mooltipass/minible_hw/README.md

# minible_hw
Repository for the Mini BLE Hardware

## [](#header-2)Licenses
<p align="center">
  Mooltipass Mini BLE
</p>
