mooltipass/minible_hw/(threads)

Thread 1 (2020-08-18):

Few questions about sourcing some parts

jeandet, 2020-08-18:
Hello, first thanks for this awesome HW!
I wanted one for a log time but previous models aren't available and delay for mini ble was quite long, so I decided to make my own one!
I've everything except:
- Smart card socket, from design I can't find a matching ref online.
- SRBE210200's plastic wheel, when I ordered it I didn't anticipate that it would be without the wheel. Then I tried to find something online but no luck and ALPS docs aren't much helpful.
- OLED screen, references aren't so difficult to find, the issue is more to source it inside Europe.
That would be awesome if you could share the references you use.

limpkin, 2020-08-26:
- smartcard socket: https://www.alibaba.com/trade/search?fsb=y&IndexArea=product_en&CatId=&SearchText=KF011C&viewtype=&tab=
- plastic wheel: these are custom made by us.. send me an email at support[at]themooltipass[dot]com and i'll have some shipped to you
- oled screen: we're sourcing from china actually...

Closed 2020-08-26.

Thread 2 (2020-10-23):

Replace the wheel by 3 buttons

Trim, 2020-10-23:
Hello,

I don't know how far this new product is from shipping, but I wanted to do a hardware suggestion.

I'm owner of a Mooltipass Mini and it felt down by accident on the ground this night. It seems that the wheel took all the shock.

Now the Mooltipass Mini is broken because the wheel is pressed down and I've discovered, I won't be able to repair it [without breaking the case](https://fry.blueblue.fr/mpm/teardown/).

So, after this experience, I think the wheel is very fragile [1] and it should be replaced by three buttons to navigate on the menus (with the middle button as validating button).

The advantage of the button is they are more robust and, with software, we can simulate fast scroll when the button is kept pressed.

In conclusion, if this new Mini BLE can have bluetooth and the 3 buttons, I think the hardware will be way more robust, because the USB port will be less pluged in/out and the buttons will be well protected by the case.

[1]: even with normal usage, my wheel didn't work very well any more because some of the steps seemed to be to used and didn't give signal to the hardware.

Thread 3 (2021-06-25):

Hardware: Scroll wheel too slippery, design change recommendation

kbembedded, 2021-06-25:
The scroll wheel on the miniBLE does not have a stiff enough knurling on it to allow good finger contact. Its very rounded, and in cold, dry climates, a finger tends to slide across it rather than spin it. This requires more pressure to get the wheel to turn, which results in spurious wheel clicks.

If there are going to be further builds through the future and lifetime of the miniBLE, I highly recommend finding a different scroll wheel design or working with the manufacturer.

As a workaround, I'm going to try to do some light filing on the one I have here. If I find it to be successful I can report back with photos and more information for others.

Thread 4 (2021-07-29):

Feature Request- Add battery disconnect switch.

SeanSingh, 2021-07-29:
Missing feature

Add a small, physical, difficult to reach switch, inline with the battery, to act as a battery disconnect. Does not need to be externally accessible.
Justification

I noticed that the battery would need to be de-soldered, to replace or repair any other part.

The connector to the display is very flimsy, to replace the display, the battery has to be de-soldered, because there is no switch.
Workarounds

Are there any workarounds you currently have in place because the feature is missing?

8<------------------------ END FEATURE REQUEST --------------------------------

Thread 5 (2025-06-26):

Bluetooth ATBTLC1000A-MU-T obsolete

lcp5y3, 2025-06-26:
The Bluetooth chip [ATBTLC1000A-MU-T](https://www.digikey.com/en/products/detail/microchip-technology/ATBTLC1000A-MU-T/6831868) is no longer available.

Digikey suggest the [SX1231HIMLTRT](https://www.digikey.com/en/products/detail/semtech-corporation/SX1231HIMLTRT/4259558) as replacement part, but it's not pin-to-pin compatible.

Microchip had a chip with same package [ISO1871](https://www.digikey.com/en/products/detail/microchip-technology/IS1871SF-102/13557888) but it's not pin-to-pin compatible.

So, have you already choose a replacement part for this chip ?
