mooltipass/minible_hw/dev_board/mini_ble.kicad_pcb

## KiCad design dev_board/mini_ble.kicad_pcb (2020-07-23)

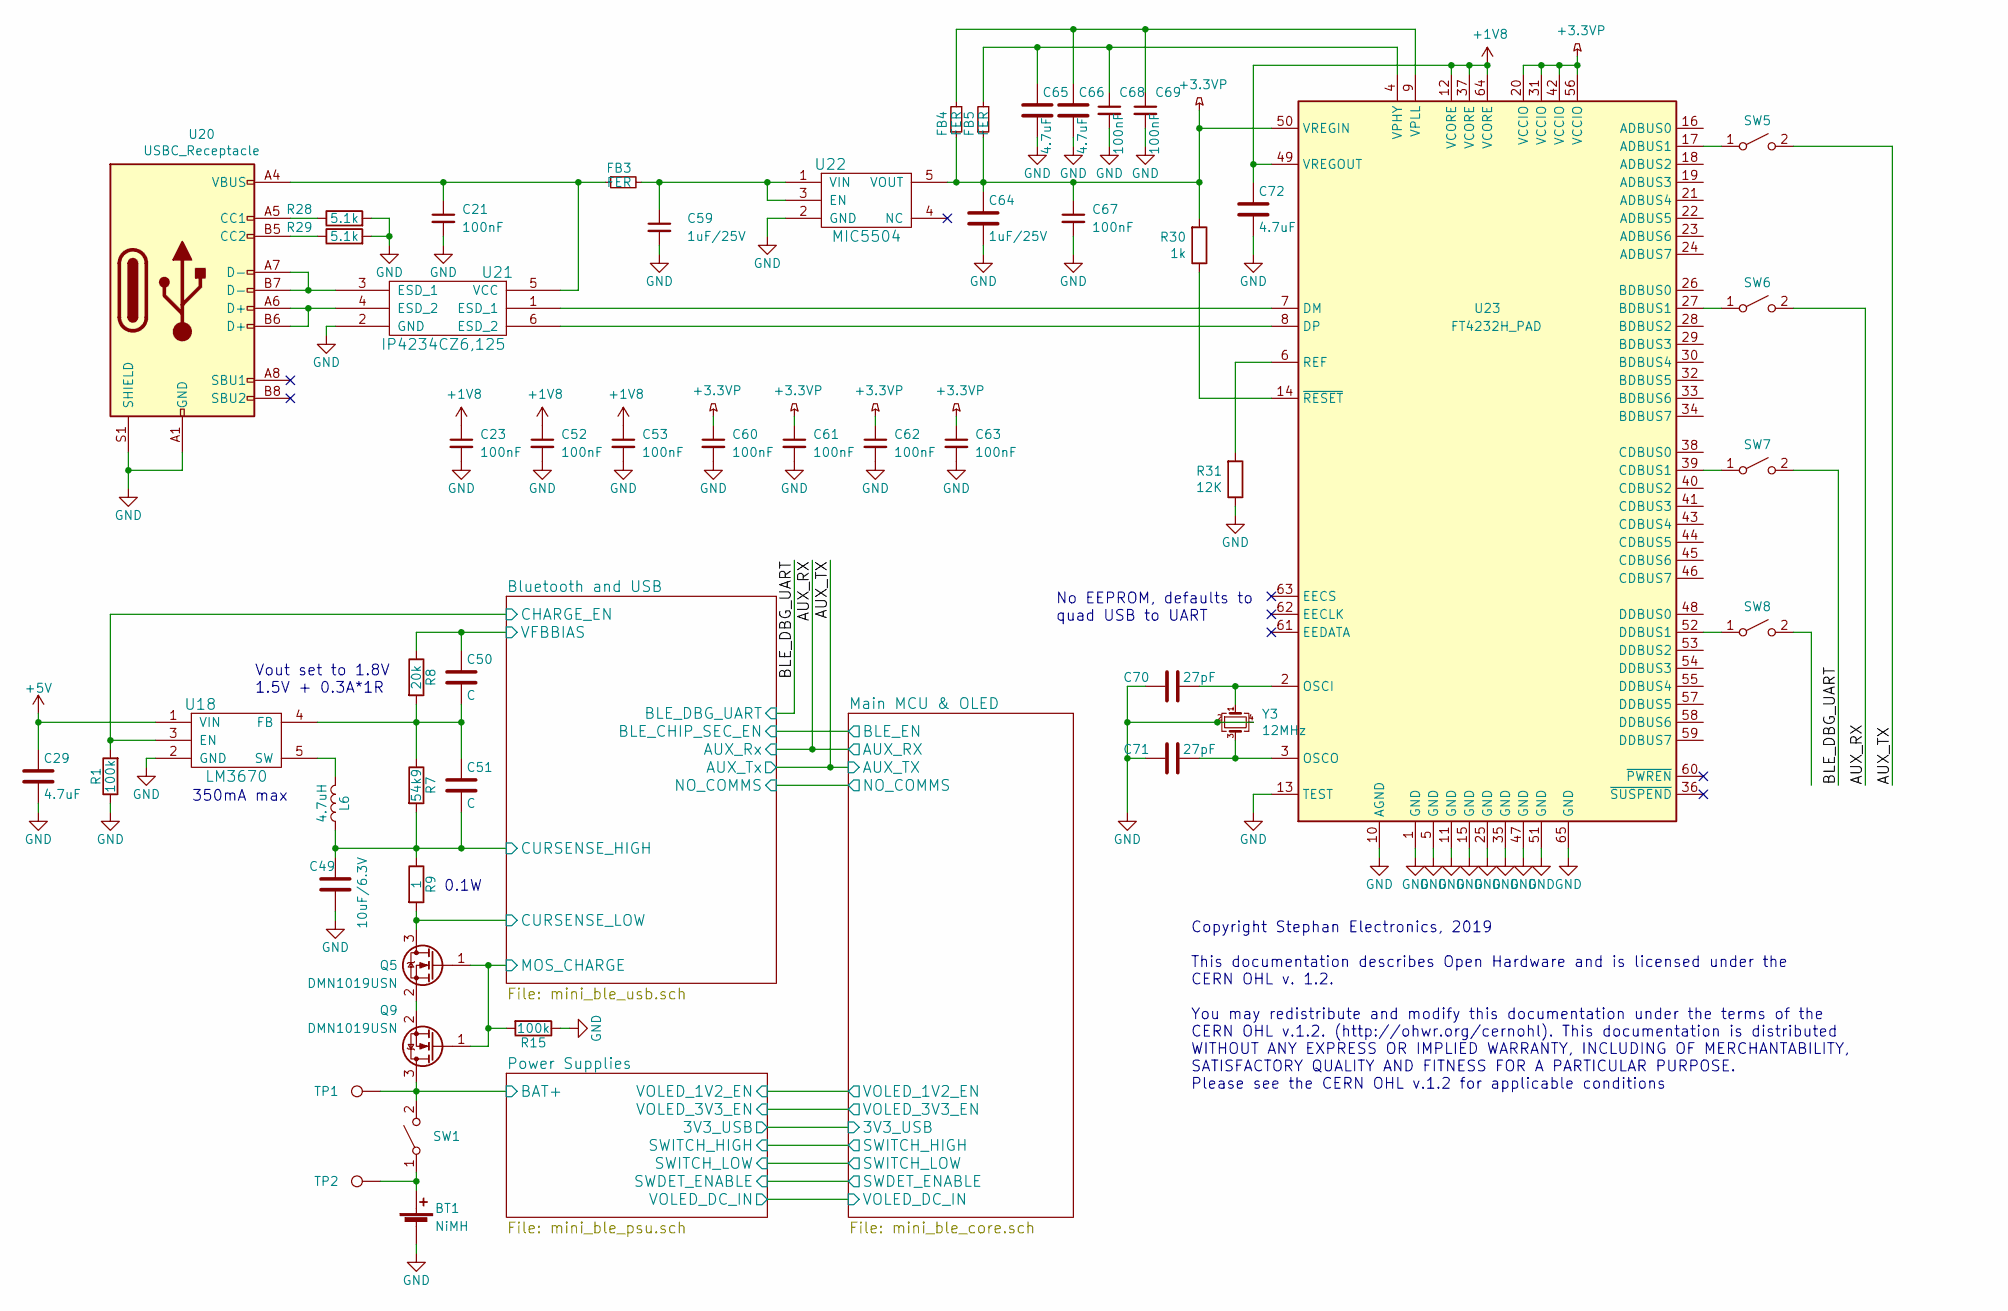
[picture p5: schematic mini_ble.sch]

Parts:
BT1: NiMH; BAT_TWOTHIRD_AAA
C21, C23, C52, C53, C60, C61, C62, C63, C67, C68, C69: 100nF; C_0603_1608Metric
C29, C65, C66, C72: 4.7uF; C_0603_1608Metric
C49: 10uF/6.3V; C_0603_1608Metric
C50, C51: C; C_0402_1005Metric
C59, C64: 1uF/25V; C_0603_1608Metric
C70, C71: 27pF; C_0402_1005Metric
FB3, FB4, FB5: FER; R_0603_1608Metric
L6: 4.7uH; L_0805_2012Metric
Q5, Q9: DMN1019USN; SC-59
R1, R15: 100k; R_0402_1005Metric
R7: 54k9; R_0402_1005Metric
R8: 20k; R_0402_1005Metric
R9: 1; R_0603_1608Metric
R28, R29: 5.1k; R_0402_1005Metric
R30: 1k; R_0402_1005Metric
R31: 12K; R_0402_1005Metric
SW1, SW5, SW6, SW7, SW8: SW_SPST; DIP_1POS_KAE01LAGT
TP1, TP2: TestPoint; TP_KEYSTONE_500X
U18: LM3670; SOT-23-5
U20: USBC_Receptacle; USB_C_Receptacle_GT-USB-7010
U21: IP4234CZ6,125; TSOP-6_1.65x3.05mm_P0.95mm
U22: MIC5504; SOT-23-5
U23: FT4232H_PAD; QFN-64-1EP_9x9mm_P0.5mm_EP4.35x4.35mm
Y3: 12MHz; Crystal_SMD_2520-4Pin_2.5x2.0mm

Connections:
+1V5: Q9.3 (D), SW1.2 (B), TP1.1; also elsewhere on the board
+1V8: C23.1, C52.1, C53.1, C72.1, U23.12 (VCORE), U23.37 (VCORE), U23.49 (VREGOUT), U23.64 (VCORE)
+3.3VP: C60.1, C61.1, C62.1, C63.1, C64.1, C67.1, FB4.1, FB5.1, R30.2, U22.5 (VOUT), U23.20 (VCCIO), U23.31 (VCCIO), U23.42 (VCCIO), U23.50 (VREGIN), U23.56 (VCCIO)
+5V: C29.1, U18.1 (VIN); also elsewhere on the board
/AUX_RX: SW6.2 (B); also elsewhere on the board
/AUX_TX: SW5.2 (B); also elsewhere on the board
/BLE_DBG_UART: SW7.2 (B); also elsewhere on the board
/Bluetooth and USB/CHARGE_EN: R1.2, U18.3 (EN); also elsewhere on the board
/Bluetooth and USB/CURSENSE_HIGH: C49.1, C51.2, L6.1, R7.2, R9.1; also elsewhere on the board
/Bluetooth and USB/CURSENSE_LOW: Q5.3 (D), R9.2; also elsewhere on the board
/Bluetooth and USB/MOS_CHARGE: Q5.1 (G), Q9.1 (G), R15.2; also elsewhere on the board
/Bluetooth and USB/VFBBIAS: C50.1, R8.1; also elsewhere on the board
GND: BT1.2 (-), C21.2, C23.2, C29.2, C49.2, C52.2, C53.2, C59.2, C60.2, C61.2, C62.2, C63.2, C64.2, C65.2, C66.2, C67.2, C68.2, C69.2, C70.1, C71.1, C72.2, R1.1, R15.1, R28.2, R29.2, R31.1, U18.2 (GND), U20.A1 (GND), U20.A12 (GND), U20.B1 (GND), U20.B12 (GND), U20.S1 (SHIELD), U21.2 (GND), U22.2 (GND), U23.1 (GND), U23.5 (GND), U23.10 (AGND), U23.11 (GND), U23.13 (TEST), U23.15 (GND), U23.25 (GND), U23.35 (GND), U23.47 (GND), U23.51 (GND), U23.65 (GND), Y3.2, Y3.4; also elsewhere on the board
unnamed: BT1.1 (+), SW1.1 (A), TP2.1
unnamed: C21.1, FB3.1, U20.A4 (VBUS), U20.A9 (VBUS), U20.B4 (VBUS), U20.B9 (VBUS), U21.5 (VCC)
unnamed: C50.2, C51.1, R7.1, R8.2, U18.4 (FB)
unnamed: C59.1, FB3.2, U22.1 (VIN), U22.3 (EN)
unnamed: C65.1, C68.1, FB5.2, U23.4 (VPHY)
unnamed: C66.1, C69.1, FB4.2, U23.9 (VPLL)
unnamed: C70.2, U23.2 (OSCI), Y3.1
unnamed: C71.2, U23.3 (OSCO), Y3.3
unnamed: L6.2, U18.5 (SW)
unnamed: Q5.2 (S), Q9.2 (S)
unnamed: R28.1, U20.A5 (CC1)
unnamed: R29.1, U20.B5 (CC2)
unnamed: R30.1, U23.14 (~RESET)
unnamed: R31.2, U23.6 (REF)
unnamed: SW5.1 (A), U23.17 (ADBUS1)
unnamed: SW6.1 (A), U23.27 (BDBUS1)
unnamed: SW7.1 (A), U23.39 (CDBUS1)
unnamed: SW8.1 (A), U23.52 (DDBUS1)
unnamed: U20.A6 (D+), U20.B6 (D+), U21.4 (ESD_2)
unnamed: U20.A7 (D-), U20.B7 (D-), U21.3 (ESD_1)
unnamed: U21.1 (ESD_1), U23.7 (DM)
unnamed: U21.6 (ESD_2), U23.8 (DP)

Notes on the sheet:
Copyright Stephan Electronics, 2019 This documentation describes Open Hardware and is licensed under the CERN OHL v. 1.2. You may redistribute and modify this documentation under the terms of the CERN OHL v.1.2. (http://ohwr.org/cernohl). This documentation is distributed WITHOUT ANY EXPRESS OR IMP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
350mA max
Vout set to 1.8V 1.5V + 0.3A*1R
0.1W
No EEPROM, defaults to quad USB to UART

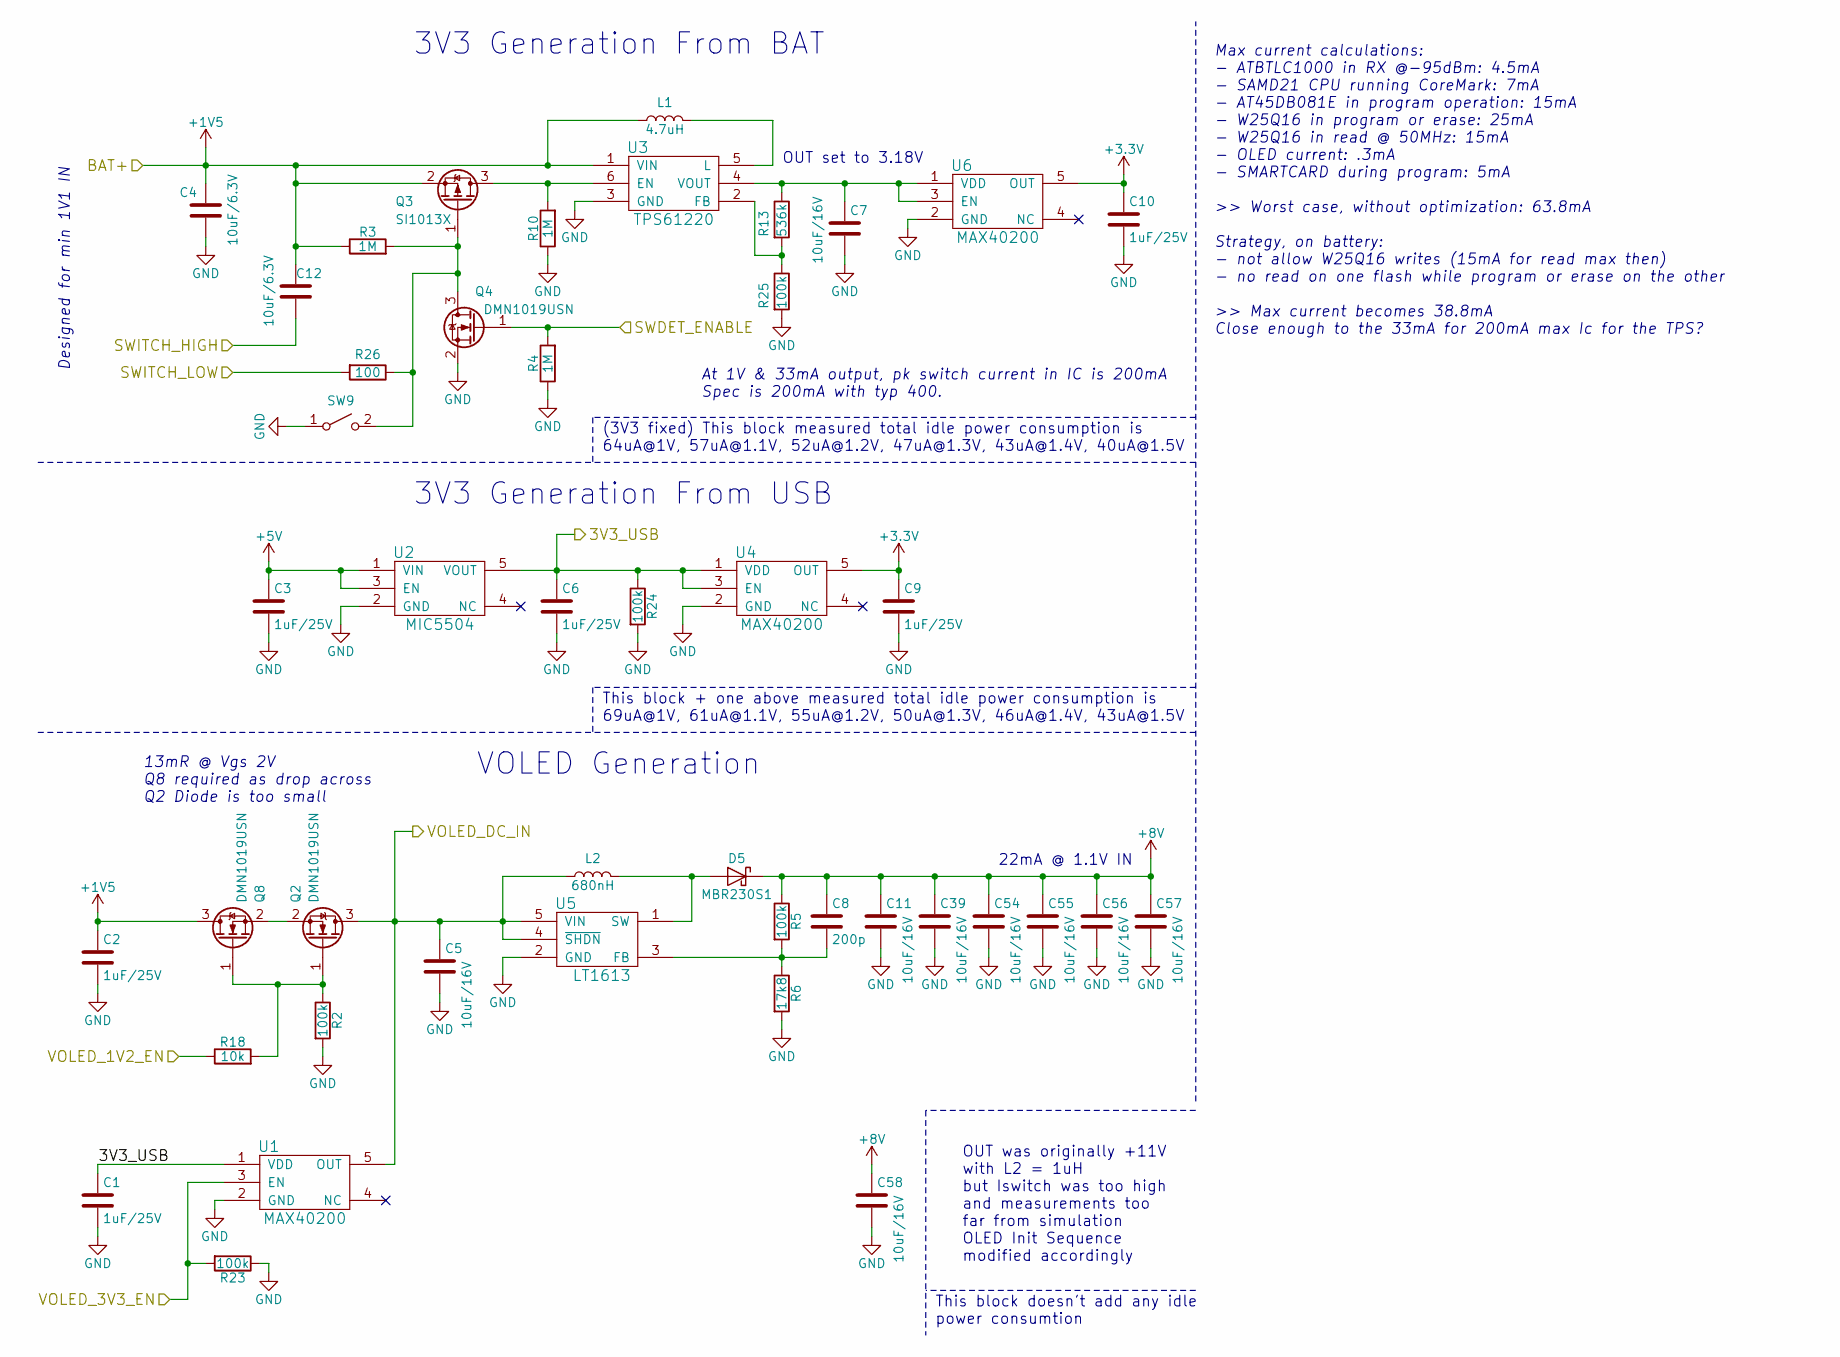
[picture p6: schematic mini_ble_psu.sch]

Parts:
C1, C2, C3, C6, C9, C10: 1uF/25V; C_0603_1608Metric
C4, C12: 10uF/6.3V; C_0603_1608Metric
C5, C7, C11, C39, C54, C55, C56, C57, C58: 10uF/16V; C_0805_2012Metric
C8: 200p; C_0402_1005Metric
D5: MBR230S1; D_SOD-123F
L1: 4.7uH; L_0805_2012Metric
L2: 680nH; L_0806
Q2, Q4, Q8: DMN1019USN; SC-59
Q3: SI1013X; SC89
R2, R5, R23, R24, R25: 100k; R_0402_1005Metric
R3, R4, R10: 1M; R_0402_1005Metric
R6: 17k8; R_0402_1005Metric
R13: 536k; R_0402_1005Metric
R18: 10k; R_0402_1005Metric
R26: 100; R_0402_1005Metric
SW9: SW_SPST; SWITCH_PUSH_6X3.5mm
U1, U4, U6: MAX40200; SOT-23-5
U2: MIC5504; SOT-23-5
U3: TPS61220; SOT-363_SC-70-6
U5: LT1613; TSOT-23-5

Connections:
+1V5: C2.1, C4.1, C12.1, L1.1, Q3.2 (S), Q8.3 (D), R3.1, U3.1 (VIN); also elsewhere on the board
+5V: C3.1, U2.1 (VIN), U2.3 (EN); also elsewhere on the board
+8V: C8.1, C11.1, C39.1, C54.1, C55.1, C56.1, C57.1, C58.1, D5.1 (K), R5.1; also elsewhere on the board
/Main MCU & OLED/3V3_USB: C1.1, C6.1, R24.1, U1.1 (VDD), U2.5 (VOUT), U4.1 (VDD), U4.3 (EN); also elsewhere on the board
/Main MCU & OLED/SWDET_ENABLE: Q4.1 (G), R4.2; also elsewhere on the board
/Main MCU & OLED/SWITCH_HIGH: C12.2; also elsewhere on the board
/Main MCU & OLED/SWITCH_LOW: R26.2; also elsewhere on the board
/Main MCU & OLED/VOLED_1V2_EN: R18.1; also elsewhere on the board
/Main MCU & OLED/VOLED_3V3_EN: R23.2, U1.3 (EN); also elsewhere on the board
/Main MCU & OLED/VOLED_DC_IN: C5.1, L2.1, Q2.3 (D), U1.5 (OUT), U5.4 (~SHDN), U5.5 (VIN); also elsewhere on the board
GND: C1.2, C2.2, C3.2, C4.2, C5.2, C6.2, C7.2, C9.2, C10.2, C11.2, C39.2, C54.2, C55.2, C56.2, C57.2, C58.2, Q4.2 (S), R2.2, R4.1, R6.2, R10.1, R23.1, R24.2, R25.2, SW9.1 (A), U1.2 (GND), U2.2 (GND), U3.3 (GND), U4.2 (GND), U5.2 (GND), U6.2 (GND); also elsewhere on the board
unnamed: C7.1, R13.1, U3.4 (VOUT), U6.1 (VDD), U6.3 (EN)
unnamed: C8.2, R5.2, R6.1, U5.3 (FB)
unnamed: D5.2 (A), L2.2, U5.1 (SW)
unnamed: L1.2, U3.5 (L)
unnamed: Q2.1 (G), Q8.1 (G), R2.1, R18.2
unnamed: Q2.2 (S), Q8.2 (S)
unnamed: Q3.1 (G), Q4.3 (D), R3.2, R26.1, SW9.2 (B)
unnamed: Q3.3 (D), R10.2, U3.6 (EN)
unnamed: R13.2, R25.1, U3.2 (FB)

Notes on the sheet:
3V3 Generation From USB
3V3 Generation From BAT
VOLED Generation
At 1V & 33mA output, pk switch current in IC is 200mA Spec is 200mA with typ 400.
Max current calculations: - ATBTLC1000 in RX @-95dBm: 4.5mA - SAMD21 CPU running CoreMark: 7mA - AT45DB081E in program operation: 15mA - W25Q16 in program or erase: 25mA - W25Q16 in read @ 50MHz: 15mA - OLED current: .3mA - SMARTCARD during program: 5mA >> Worst case, without optimization: 63.8mA S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
Designed for min 1V1 IN
13mR @ Vgs 2V Q8 required as drop across Q2 Diode is too small
(3V3 fixed) This block measured total idle power consumption is 64uA@1V, 57uA@1.1V, 52uA@1.2V, 47uA@1.3V, 43uA@1.4V, 40uA@1.5V
This block + one above measured total idle power consumption is 69uA@1V, 61uA@1.1V, 55uA@1.2V, 50uA@1.3V, 46uA@1.4V, 43uA@1.5V
This block doesn't add any idle power consumtion
22mA @ 1.1V IN
OUT was originally +11V with L2 = 1uH but Iswitch was too high and measurements too far from simulation OLED Init Sequence modified accordingly
OUT set to 3.18V

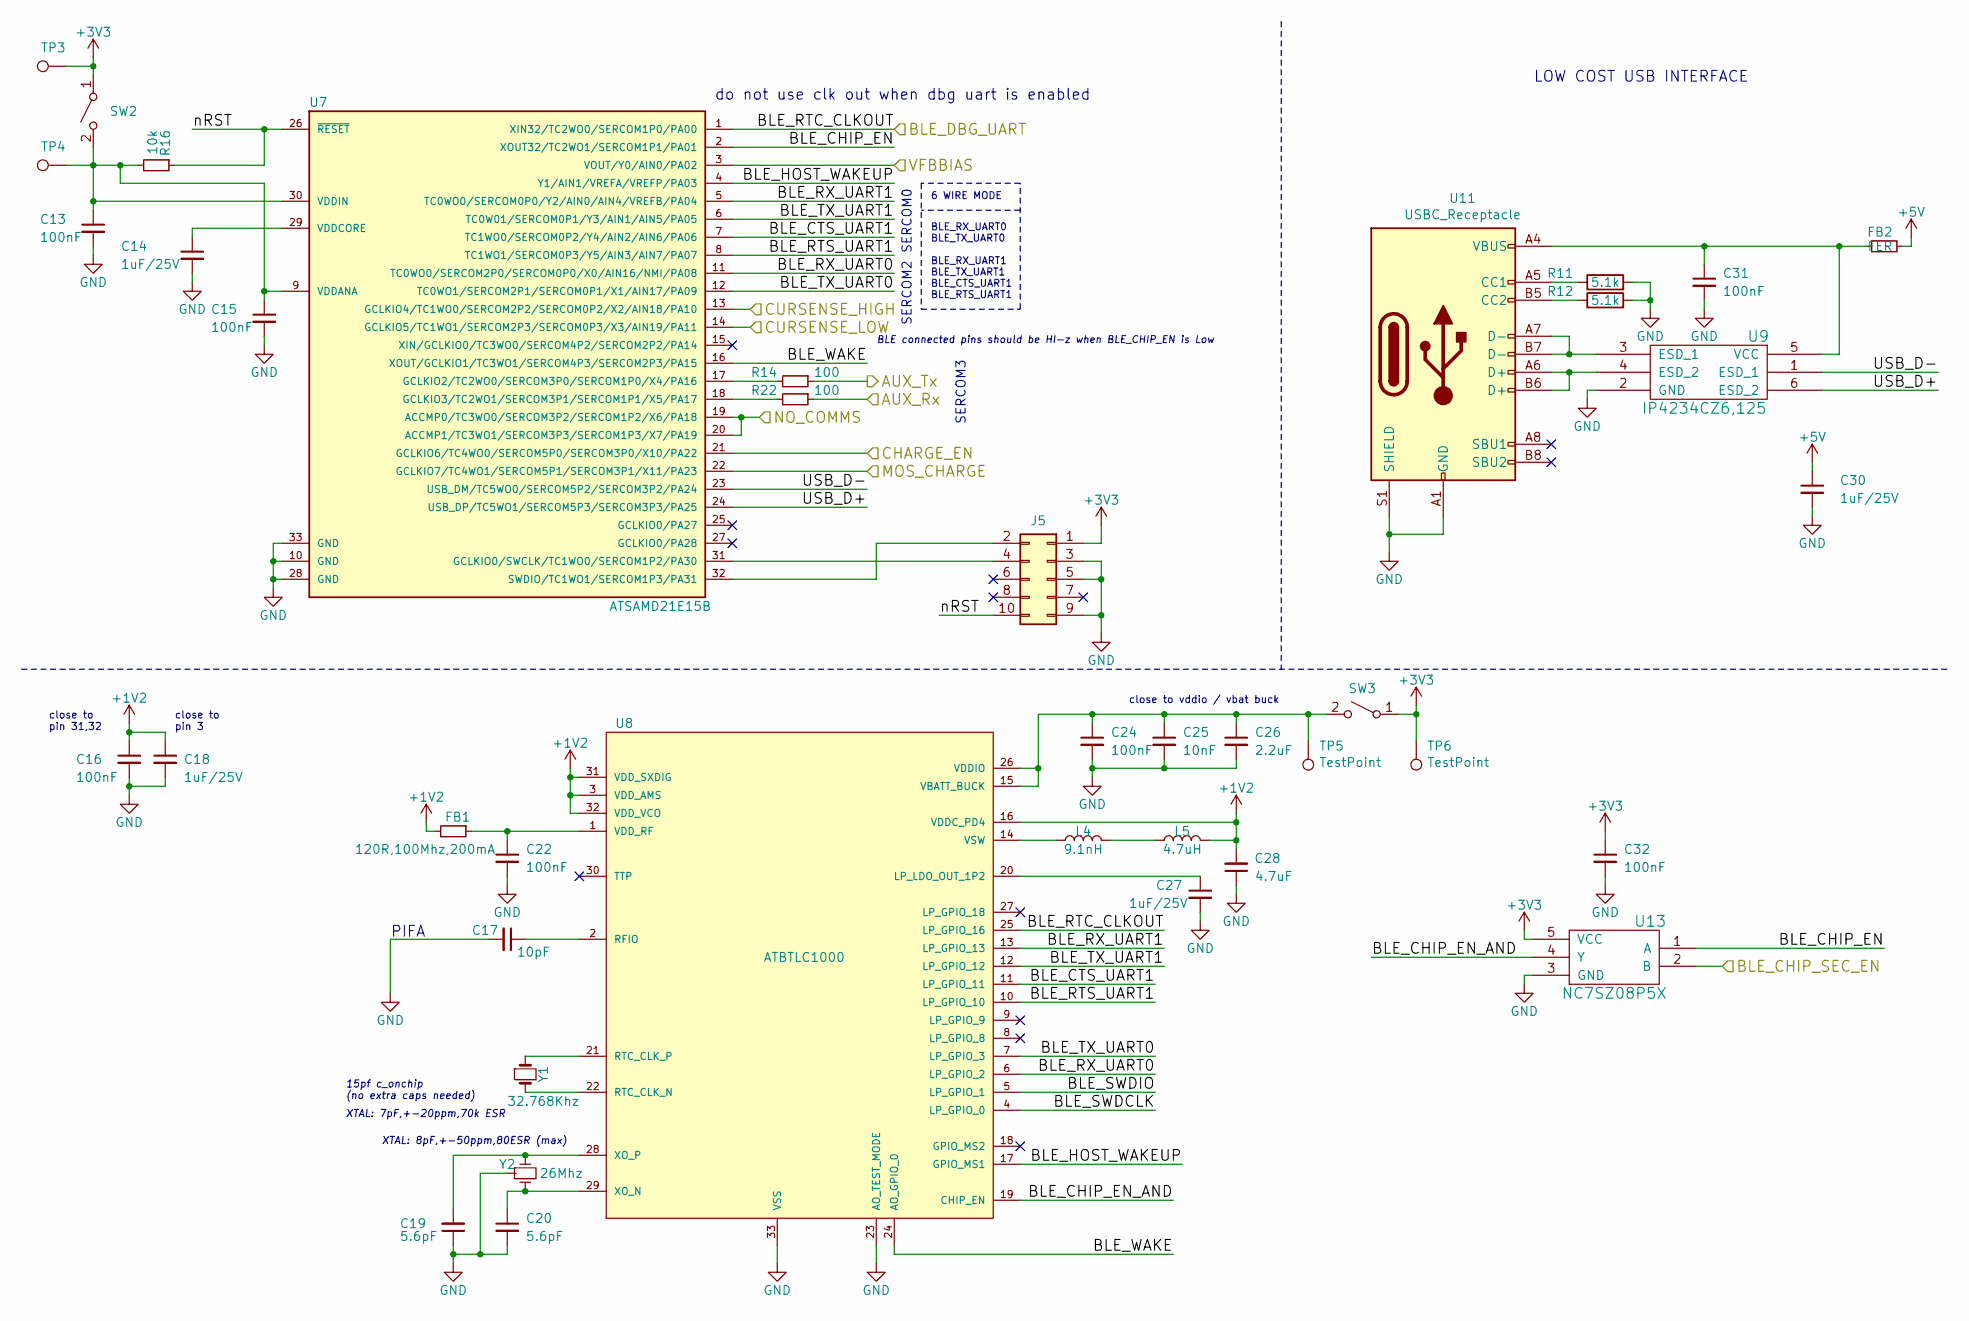
[picture p7: schematic mini_ble_usb.sch]

Parts:
C13, C15, C16, C22, C24, C31, C32: 100nF; C_0603_1608Metric
C14, C18, C27, C30: 1uF/25V; C_0603_1608Metric
C17: 10pF; C_0402_1005Metric
C19, C20: 5.6pF; C_0402_1005Metric
C25: 10nF; C_0603_1608Metric
C26: 2.2uF; C_0603_1608Metric
C28: 4.7uF; C_0603_1608Metric
FB1: 120R,100Mhz,200mA; R_0603_1608Metric
FB2: FER; R_0603_1608Metric
J5: Conn_02x05_Odd_Even; SHF-105-01-X-D-TH
L4: 9.1nH; L_0603_1608Metric
L5: 4.7uH; L_0805_2012Metric
R11, R12: 5.1k; R_0402_1005Metric
R14, R22: 100; R_0402_1005Metric
R16: 10k; R_0402_1005Metric
SW2, SW3: SW_SPST; DIP_1POS_KAE01LAGT
TP3, TP4, TP5, TP6: TestPoint; TP_KEYSTONE_500X
U7: ATSAMD21E15B; QFN-32-1EP_5x5mm_P0.5mm_EP3.7x3.7mm
U8: ATBTLC1000; QFN-32-1EP_4x4mm_Pitch0.4mm
U9: IP4234CZ6,125; TSOP-6_1.65x3.05mm_P0.95mm
U11: USBC_Receptacle; USB_C_Receptacle_GT-USB-7010
U13: NC7SZ08P5X; SOT-353_SC-70-5
Y1: 32.768Khz; Crystal_SMD_3215-2Pin_3.2x1.5mm
Y2: 26Mhz; Crystal_SMD_2016-4Pin_2.0x1.6mm

Connections:
+1V2: C16.1, C18.1, C28.2, FB1.2, L5.2, U8.3 (VDD_AMS), U8.16 (VDDC_PD4), U8.31 (VDD_SXDIG), U8.32 (VDD_VCO)
+5V: C30.1, FB2.2; also elsewhere on the board
/AUX_RX: R22.1; also elsewhere on the board
/AUX_TX: R14.1; also elsewhere on the board
/BLE_DBG_UART: U7.1 (XIN32/TC2WO0/SERCOM1P0/PA00), U8.25 (LP_GPIO_16); also elsewhere on the board
/Bluetooth and USB/BLE_CHIP_EN: U7.2 (XOUT32/TC2WO1/SERCOM1P1/PA01), U13.1 (A)
/Bluetooth and USB/BLE_CHIP_EN_AND: U8.19 (CHIP_EN), U13.4 (Y)
/Bluetooth and USB/BLE_CHIP_SEC_EN: U13.2 (B); also elsewhere on the board
/Bluetooth and USB/BLE_CTS_UART1: U7.7 (TC1WO0/SERCOM0P2/Y4/AIN2/AIN6/PA06), U8.11 (LP_GPIO_11)
/Bluetooth and USB/BLE_HOST_WAKEUP: U7.4 (Y1/AIN1/VREFA/VREFP/PA03), U8.17 (GPIO_MS1)
/Bluetooth and USB/BLE_RTS_UART1: U7.8 (TC1WO1/SERCOM0P3/Y5/AIN3/AIN7/PA07), U8.10 (LP_GPIO_10)
/Bluetooth and USB/BLE_RX_UART0: U7.11 (TC0WO0/SERCOM2P0/SERCOM0P0/X0/AIN16/NMI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), U8.6 (LP_GPIO_2)
/Bluetooth and USB/BLE_RX_UART1: U7.5 (TC0WO0/SERCOM0P0/Y2/AIN0/AIN4/VREFB/PA04), U8.13 (LP_GPIO_13)
/Bluetooth and USB/BLE_SWDCLK: U8.4 (LP_GPIO_0)
/Bluetooth and USB/BLE_SWDIO: U8.5 (LP_GPIO_1)
/Bluetooth and USB/BLE_TX_UART0: U7.12 (TC0WO1/SERCOM2P1/SERCOM0P1/X1/AIN17/PA09), U8.7 (LP_GPIO_3)
/Bluetooth and USB/BLE_TX_UART1: U7.6 (TC0W01/SERCOM0P1/Y3/AIN1/AIN5/PA05), U8.12 (LP_GPIO_12)
/Bluetooth and USB/BLE_WAKE: U7.16 (XOUT/GCLKIO1/TC3WO1/SERCOM4P3/SERCOM2P3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), U8.24 (AO_GPIO_0)
/Bluetooth and USB/CHARGE_EN: U7.21 (GCLKIO6/TC4WO0/SERCOM5P0/SERCOM3P0/X10/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); also elsewhere on the board
/Bluetooth and USB/CURSENSE_HIGH: U7.13 (GCLKIO4/TC1WO0/SERCOM2P2/SERCOM0P2/X2/A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); also elsewhere on the board
/Bluetooth and USB/CURSENSE_LOW: U7.14 (GCLKIO5/TC1WO1/SERCOM2P3/SERCOM0P3/X3/A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); also elsewhere on the board
/Bluetooth and USB/MOS_CHARGE: U7.22 (GCLKIO7/TC4WO1/SERCOM5P1/SERCOM3P1/X11/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); also elsewhere on the board
/Bluetooth and USB/NO_COMMS: U7.19 (ACCMP0/TC3WO0/SERCOM3P2/SERCOM1P2/X6/PA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), U7.20 (ACCMP1/TC3WO1/SERCOM3P3/SERCOM1P3/X7/PA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); also elsewhere on the board
/Bluetooth and USB/USB_D+: U7.24 (USB_DP/TC5WO1/SERCOM5P3/SERCOM3P3/PA25), U9.6 (ESD_2)
/Bluetooth and USB/USB_D-: U7.23 (USB_DM/TC5WO0/SERCOM5P2/SERCOM3P2/PA24), U9.1 (ESD_1)
/Bluetooth and USB/VFBBIAS: U7.3 (VOUT/Y0/AIN0/PA02); also elsewhere on the board
/Bluetooth and USB/nRST: J5.10, R16.1, U7.26 (~RESET~)
GND: C13.2, C14.2, C15.2, C16.2, C17.2, C18.2, C19.1, C20.2, C22.2, C24.2, C25.2, C26.2, C27.2, C28.1, C30.2, C31.2, C32.2, J5.3, J5.5, J5.9, R11.2, R12.2, U7.10 (GND), U7.28 (GND), U7.33 (GND), U8.23 (AO_TEST_MODE), U8.33 (VSS), U9.2 (GND), U11.A1 (GND), U11.A12 (GND), U11.B1 (GND), U11.B12 (GND), U11.S1 (SHIELD), U13.3 (GND), Y2.2, Y2.4; also elsewhere on the board
unnamed: C13.1, C15.1, R16.2, SW2.2 (B), TP4.1, U7.9 (VDDANA), U7.30 (VDDIN)
unnamed: C14.1, U7.29 (VDDCORE)
unnamed: C17.1, U8.2 (RFIO)
unnamed: C19.2, U8.28 (XO_P), Y2.1
unnamed: C20.1, U8.29 (XO_N), Y2.3
unnamed: C22.1, FB1.1, U8.1 (VDD_RF)
unnamed: C24.1, C25.1, C26.1, SW3.2 (B), TP5.1, U8.15 (VBATT_BUCK), U8.26 (VDDIO)
unnamed: C27.1, U8.20 (LP_LDO_OUT_1P2)
unnamed: C31.1, FB2.1, U9.5 (VCC), U11.A4 (VBUS), U11.A9 (VBUS), U11.B4 (VBUS), U11.B9 (VBUS)
unnamed: J5.2, U7.32 (SWDIO/TC1WO1/SERCOM1P3/PA31)
unnamed: J5.4, U7.31 (GCLKIO0/SWCLK/TC1WO0/SERCOM1P2/PA30)
unnamed: L4.1, U8.14 (VSW)
unnamed: L4.2, L5.1
unnamed: R11.1, U11.A5 (CC1)
unnamed: R12.1, U11.B5 (CC2)
unnamed: R14.2, U7.17 (GCLKIO2/TC2WO0/SERCOM3P0/SERCOM1P0/X4/P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)
unnamed: R22.2, U7.18 (GCLKIO3/TC2WO1/SERCOM3P1/SERCOM1P1/X5/P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)
unnamed: U8.21 (RTC_CLK_P), Y1.1
unnamed: U8.22 (RTC_CLK_N), Y1.2
unnamed: U9.4 (ESD_2), U11.A6 (D+), U11.B6 (D+)
unnamed: U9.3 (ESD_1), U11.A7 (D-), U11.B7 (D-)

Notes on the sheet:
XTAL: 8pF,+-50ppm,80ESR (max)
XTAL: 7pF,+-20ppm,70k ESR
15pf c_onchip (no extra caps needed)
BLE connected pins should be HI-z when BLE_CHIP_EN is Low
close to vddio / vbat buck
LOW COST USB INTERFACE
close to pin 3
close to pin 31,32
SERCOM3
SERCOM2
SERCOM0
6 WIRE MODE
BLE_RX_UART0 BLE_TX_UART0 BLE_RX_UART1 BLE_TX_UART1 BLE_CTS_UART1 BLE_RTS_UART1
PIFA
do not use clk out when dbg uart is enabled

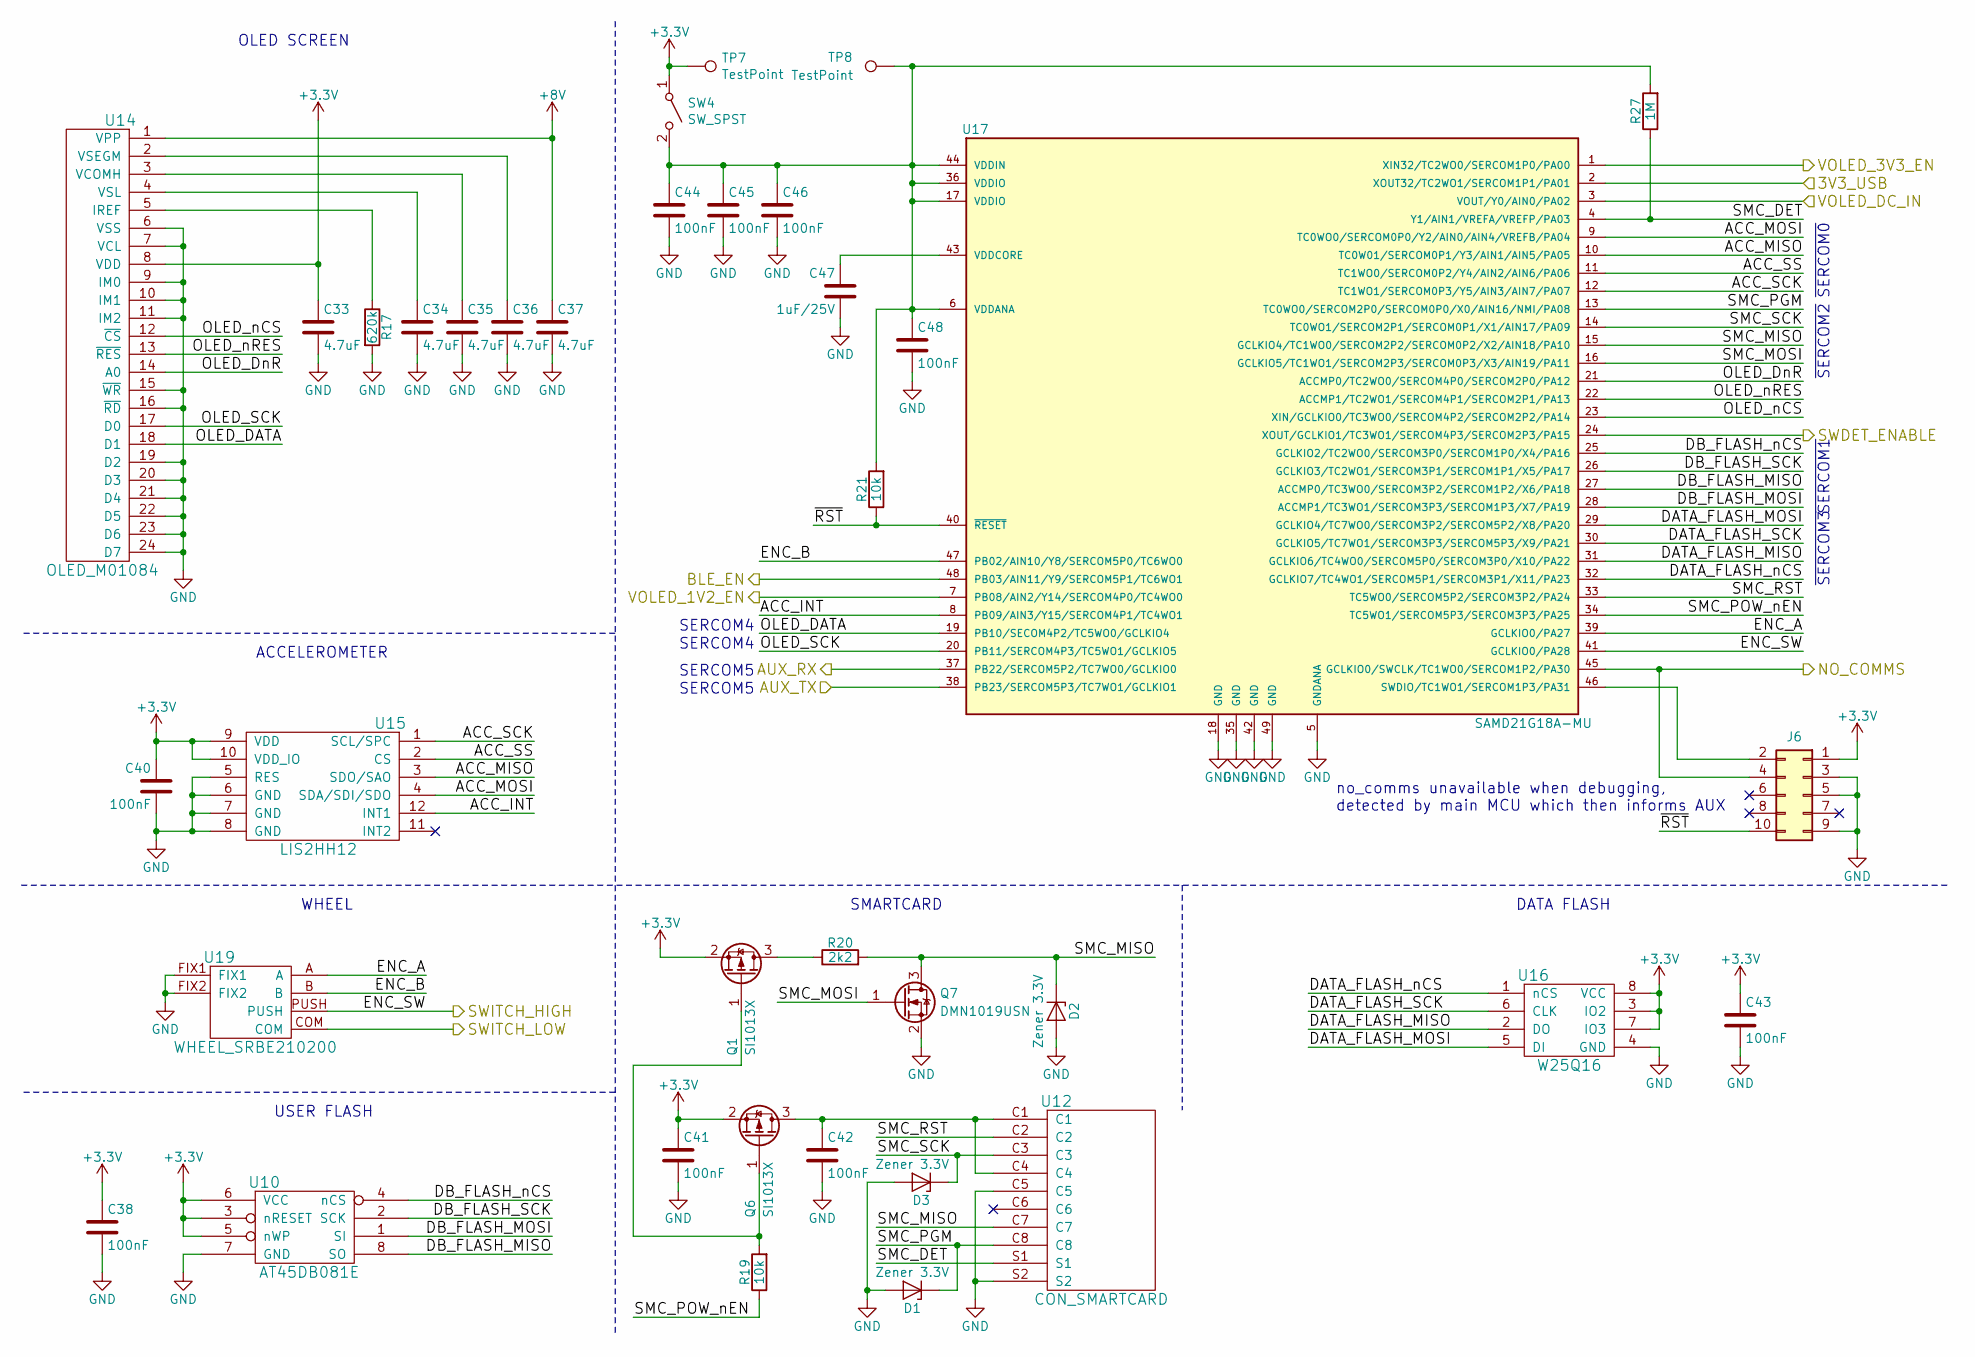
[picture p8: schematic mini_ble_core.sch]

Parts:
C33, C34, C35, C36, C37: 4.7uF; C_0603_1608Metric
C38, C40, C41, C42, C43, C44, C45, C46, C48: 100nF; C_0603_1608Metric
C47: 1uF/25V; C_0603_1608Metric
D1, D2, D3: Zener 3.3V; D_SOD-523
J6: Conn_02x05_Odd_Even; SHF-105-01-X-D-TH
Q1, Q6: SI1013X; SC89
Q7: DMN1019USN; SC-59
R17: 620k; R_0603_1608Metric
R19, R21: 10k; R_0402_1005Metric
R20: 2k2; R_0603_1608Metric
R27: 1M; R_0402_1005Metric
SW4: SW_SPST; DIP_1POS_KAE01LAGT
TP7, TP8: TestPoint; TP_KEYSTONE_500X
U10: AT45DB081E; SOIC-8_3.9x4.9mm_P1.27mm
U12: CON_SMARTCARD; CON_SMARTCARD_CLONE_91-90473-003A
U14: OLED_M01084; SCREEN_M01084
U15: LIS2HH12; LGA-12
U16: W25Q16; SOIC-8_3.9x4.9mm_P1.27mm
U17: SAMD21G18A-MU; QFN-48-1EP_7x7mm_P0.5mm_EP5.3x5.3mm
U19: WHEEL_SRBE210200; SRBE210200

Connections:
+8V: C37.1, U14.1 (VPP); also elsewhere on the board
/AUX_RX: U17.37 (PB22/SERCOM5P2/TC7WO0/GCLKIO0); also elsewhere on the board
/AUX_TX: U17.38 (PB23/SERCOM5P3/TC7WO1/GCLKIO1); also elsewhere on the board
/Bluetooth and USB/BLE_CHIP_SEC_EN: U17.48 (PB03/AIN11/Y9/SERCOM5P1/TC6WO1); also elsewhere on the board
/Bluetooth and USB/NO_COMMS: J6.4, U17.45 (GCLKIO0/SWCLK/TC1WO0/SERCOM1P2/PA30); also elsewhere on the board
/Main MCU & OLED/3V3_USB: U17.2 (XOUT32/TC2WO1/SERCOM1P1/PA01); also elsewhere on the board
/Main MCU & OLED/ACC_INT: U15.12 (INT1), U17.8 (PB09/AIN3/Y15/SERCOM4P1/TC4WO1)
/Main MCU & OLED/ACC_MISO: U15.3 (SDO/SAO), U17.10 (TC0W01/SERCOM0P1/Y3/AIN1/AIN5/PA05)
/Main MCU & OLED/ACC_MOSI: U15.4 (SDA/SDI/SDO), U17.9 (TC0WO0/SERCOM0P0/Y2/AIN0/AIN4/VREFB/PA04)
/Main MCU & OLED/ACC_SCK: U15.1 (SCL/SPC), U17.12 (TC1WO1/SERCOM0P3/Y5/AIN3/AIN7/PA07)
/Main MCU & OLED/ACC_SS: U15.2 (CS), U17.11 (TC1WO0/SERCOM0P2/Y4/AIN2/AIN6/PA06)
/Main MCU & OLED/DATA_FLASH_MISO: U16.2 (DO), U17.31 (GCLKIO6/TC4WO0/SERCOM5P0/SERCOM3P0/X10/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)
/Main MCU & OLED/DATA_FLASH_MOSI: U16.5 (DI), U17.29 (GCLKIO4/TC7WO0/SERCOM3P2/SERCOM5P2/X8/P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)
/Main MCU & OLED/DATA_FLASH_SCK: U16.6 (CLK), U17.30 (GCLKIO5/TC7WO1/SERCOM3P3/SERCOM5P3/X9/P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)
/Main MCU & OLED/DATA_FLASH_nCS: U16.1 (nCS), U17.32 (GCLKIO7/TC4WO1/SERCOM5P1/SERCOM3P1/X11/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)
/Main MCU & OLED/DB_FLASH_MISO: U10.8 (SO), U17.27 (ACCMP0/TC3WO0/SERCOM3P2/SERCOM1P2/X6/PA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)
/Main MCU & OLED/DB_FLASH_MOSI: U10.1 (SI), U17.28 (ACCMP1/TC3WO1/SERCOM3P3/SERCOM1P3/X7/PA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)
/Main MCU & OLED/DB_FLASH_SCK: U10.2 (SCK), U17.26 (GCLKIO3/TC2WO1/SERCOM3P1/SERCOM1P1/X5/P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)
/Main MCU & OLED/DB_FLASH_nCS: U10.4 (nCS), U17.25 (GCLKIO2/TC2WO0/SERCOM3P0/SERCOM1P0/X4/P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)
/Main MCU & OLED/ENC_A: U17.39 (GCLKIO0/PA27), U19.A
/Main MCU & OLED/ENC_B: U17.47 (PB02/AIN10/Y8/SERCOM5P0/TC6WO0), U19.B
/Main MCU & OLED/OLED_DATA: U14.18 (D1), U17.19 (PB10/SECOM4P2/TC5WO0/GCLKIO4)
/Main MCU & OLED/OLED_DnR: U14.14 (A0), U17.21 (ACCMP0/TC2WO0/SERCOM4P0/SERCOM2P0/PA12)
/Main MCU & OLED/OLED_SCK: U14.17 (D0), U17.20 (PB11/SERCOM4P3/TC5WO1/GCLKIO5)
/Main MCU & OLED/OLED_nCS: U14.12 (~CS), U17.23 (XIN/GCLKIO0/TC3WO0/SERCOM4P2/SERCOM2P2/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)
/Main MCU & OLED/OLED_nRES: U14.13 (~RES), U17.22 (ACCMP1/TC2WO1/SERCOM4P1/SERCOM2P1/PA13)
/Main MCU & OLED/SMC_DET: R27.1, U12.S1, U17.4 (Y1/AIN1/VREFA/VREFP/PA03)
/Main MCU & OLED/SMC_MISO: D2.1 (K), Q7.3 (D), R20.2, U12.C7, U17.15 (GCLKIO4/TC1WO0/SERCOM2P2/SERCOM0P2/X2/A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)
/Main MCU & OLED/SMC_MOSI: Q7.1 (G), U17.16 (GCLKIO5/TC1WO1/SERCOM2P3/SERCOM0P3/X3/A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)
/Main MCU & OLED/SMC_PGM: D1.1 (K), U12.C8, U17.13 (TC0WO0/SERCOM2P0/SERCOM0P0/X0/AIN16/NMI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)
/Main MCU & OLED/SMC_POW_nEN: R19.1, U17.34 (TC5WO1/SERCOM5P3/SERCOM3P3/PA25)
/Main MCU & OLED/SMC_RST: U12.C2, U17.33 (TC5WO0/SERCOM5P2/SERCOM3P2/PA24)
/Main MCU & OLED/SMC_SCK: D3.1 (K), U12.C3, U17.14 (TC0WO1/SERCOM2P1/SERCOM0P1/X1/AIN17/PA09)
/Main MCU & OLED/SWDET_ENABLE: U17.24 (XOUT/GCLKIO1/TC3WO1/SERCOM4P3/SERCOM2P3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); also elsewhere on the board
/Main MCU & OLED/SWITCH_HIGH: U17.41 (GCLKIO0/PA28), U19.PUSH; also elsewhere on the board
/Main MCU & OLED/SWITCH_LOW: U19.COM; also elsewhere on the board
/Main MCU & OLED/VOLED_1V2_EN: U17.7 (PB08/AIN2/Y14/SERCOM4P0/TC4WO0); also elsewhere on the board
/Main MCU & OLED/VOLED_3V3_EN: U17.1 (XIN32/TC2WO0/SERCOM1P0/PA00); also elsewhere on the board
/Main MCU & OLED/VOLED_DC_IN: U17.3 (VOUT/Y0/AIN0/PA02); also elsewhere on the board
/Main MCU & OLED/~RST: J6.10, R21.1, U17.40 (~RESET~)
GND: C33.2, C34.2, C35.2, C36.2, C37.2, C38.2, C40.2, C41.2, C42.2, C43.2, C44.2, C45.2, C46.2, C47.2, C48.2, D1.2 (A), D2.2 (A), D3.2 (A), J6.3, J6.5, J6.9, Q7.2 (S), R17.2, U10.7 (GND), U12.C5, U12.S2, U14.6 (VSS), U14.7 (VCL), U14.9 (IM0), U14.10 (IM1), U14.11 (IM2), U14.15 (~WR), U14.16 (~RD), U14.19 (D2), U14.20 (D3), U14.21 (D4), U14.22 (D5), U14.23 (D6), U14.24 (D7), U15.5 (RES), U15.6 (GND), U15.7 (GND), U15.8 (GND), U16.4 (GND), U17.5 (GNDANA), U17.18 (GND), U17.35 (GND), U17.42 (GND), U17.49 (GND), U19.FIX1, U19.FIX2; also elsewhere on the board
unnamed: C34.1, U14.4 (VSL)
unnamed: C35.1, U14.3 (VCOMH)
unnamed: C36.1, U14.2 (VSEGM)
unnamed: C42.1, Q6.3 (D), U12.C1, U12.C4
unnamed: C44.1, C45.1, C46.1, C48.1, R21.2, R27.2, SW4.2 (B), TP8.1, U17.6 (VDDANA), U17.17 (VDDIO), U17.36 (VDDIO), U17.44 (VDDIN)
unnamed: C47.1, U17.43 (VDDCORE)
unnamed: J6.2, U17.46 (SWDIO/TC1WO1/SERCOM1P3/PA31)
unnamed: Q1.1 (G), Q6.1 (G), R19.2
unnamed: Q1.3 (D), R20.1
unnamed: R17.1, U14.5 (IREF)

Notes on the sheet:
OLED SCREEN
ACCELEROMETER
WHEEL
USER FLASH
SMARTCARD
DATA FLASH
SERCOM5
~SERCOM1
SERCOM4
~SERCOM3
~SERCOM0
~SERCOM2
no_comms unavailable when debugging, detected by main MCU which then informs AUX

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
