mooltipass/minible_hw/dev_board/mini_ble.kicad_pcb

## KiCad design dev_board/mini_ble.kicad_pcb (continued)

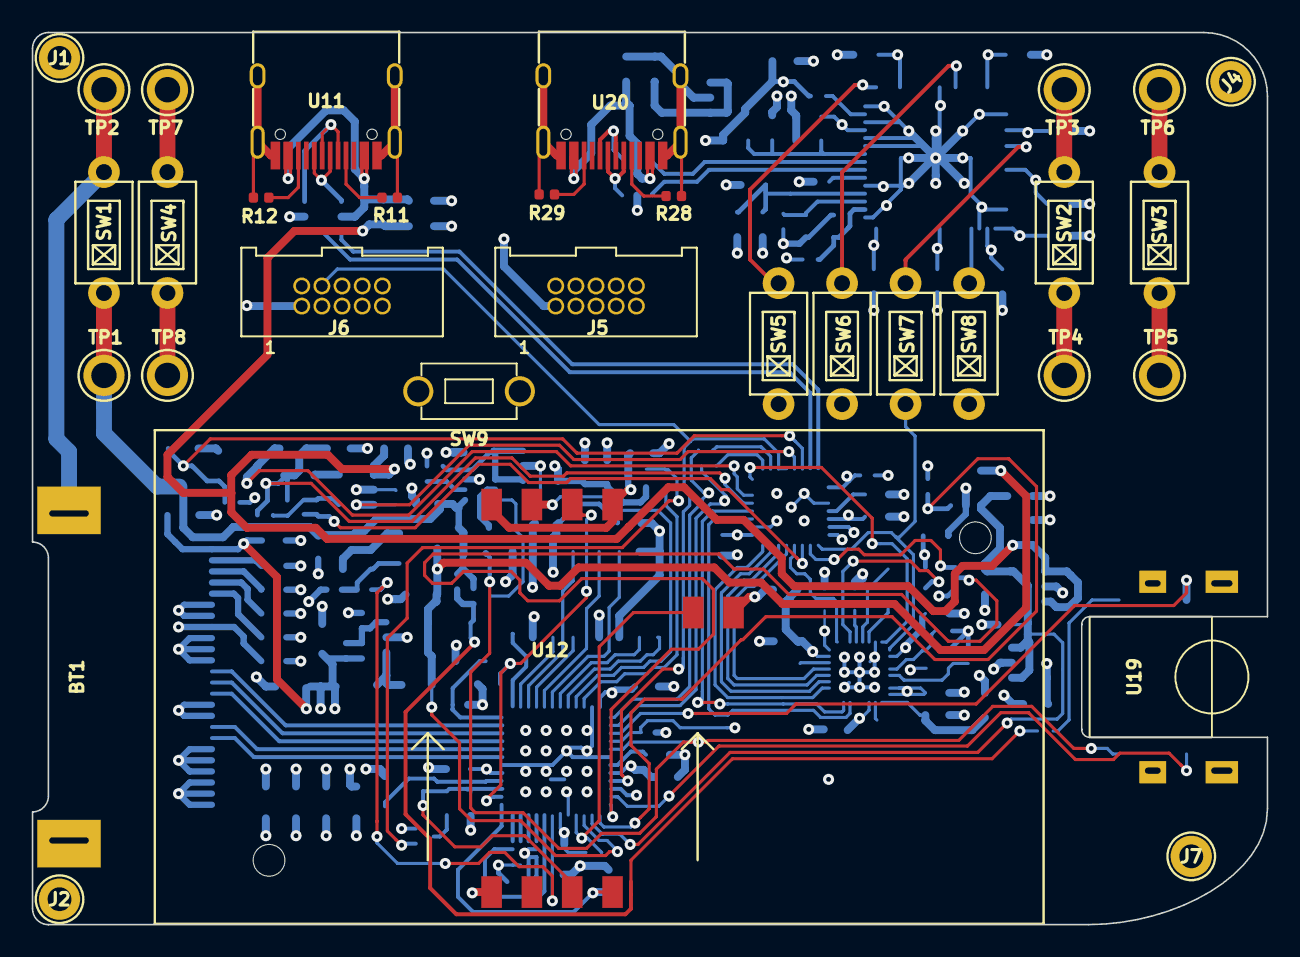
[picture p9: board mini_ble.kicad_pcb from above]

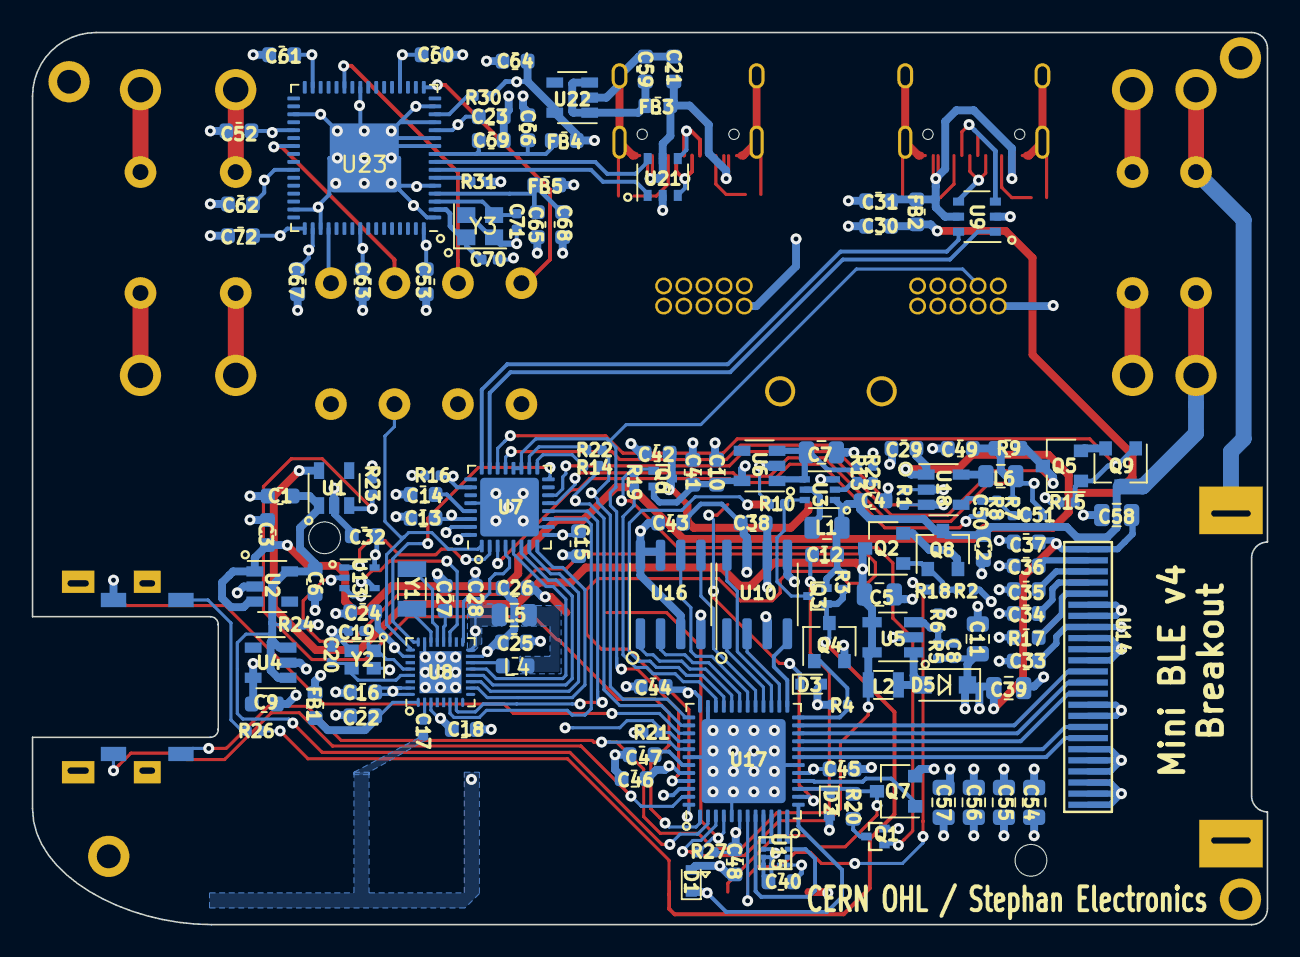
[picture p10: board mini_ble.kicad_pcb from below]

Board: 4 copper layers, 77.8 x 56.2 mm, 176 parts (144 on the bottom side), 128 nets.

Other parts of the board:
J1, J2, J4, J7: FIX_M1.4

Their connections:
GND: J1.1, J2.1, J4.1, J7.1; also elsewhere on the board
