mooltipass/minible_hw/(notices)

Notices in the files:
main_board/mini_ble.kicad_pcb:
CERN OHL / Stephan Elec.
dev_board/mini_ble.kicad_pcb:
CERN OHL / Stephan Electronics
